chungyu710/Fusion/hardware/kicad/models/SP3T.step

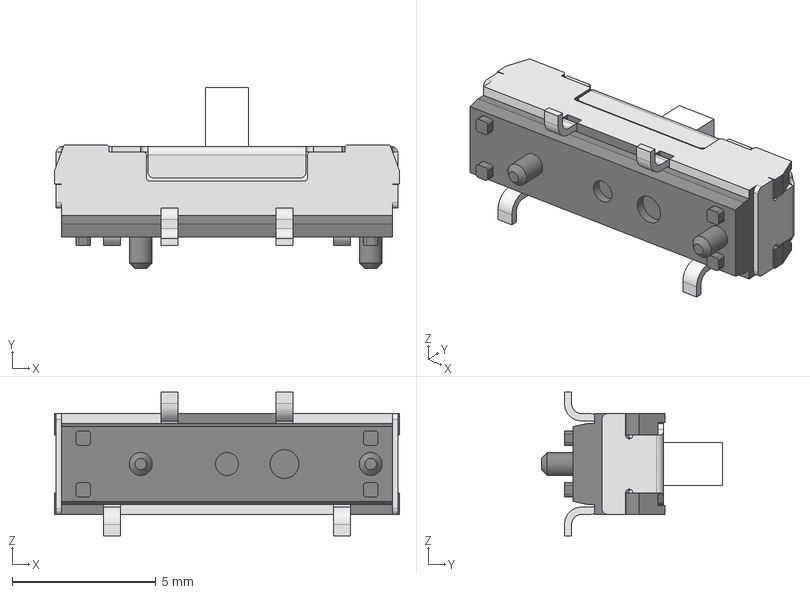
[picture p1: CAD file, 2022-07-06]
hardware/kicad/models/SP3T.step
12.0 x 6.30 x 5.00 mm
3Top setting_s
13B-01_c
