chungyu710/Fusion/hardware/kicad/models/SPDT.step

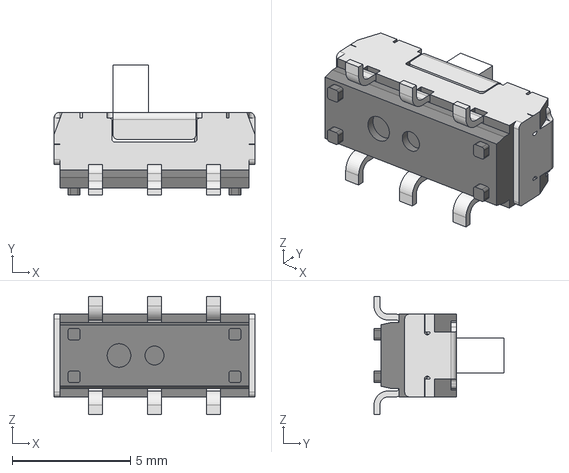
[picture p2: CAD file, 2022-07-06]
hardware/kicad/models/SPDT.step
8.50 x 5.50 x 5.00 mm
2Top setting_s
22B-01_c
