chungyu710/Fusion/hardware/kicad/models/JST.step

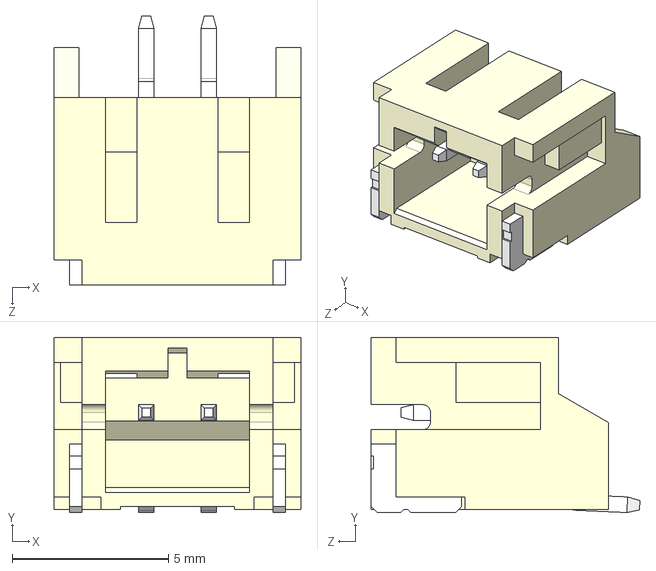
[picture p3: CAD file, 2022-07-06]
hardware/kicad/models/JST.step
7.90 x 5.60 x 8.60 mm
