chungyu710/Fusion/hardware/kicad/fusion.kicad_pcb

## KiCad design hardware/kicad/fusion.kicad_pcb (2022-07-08)

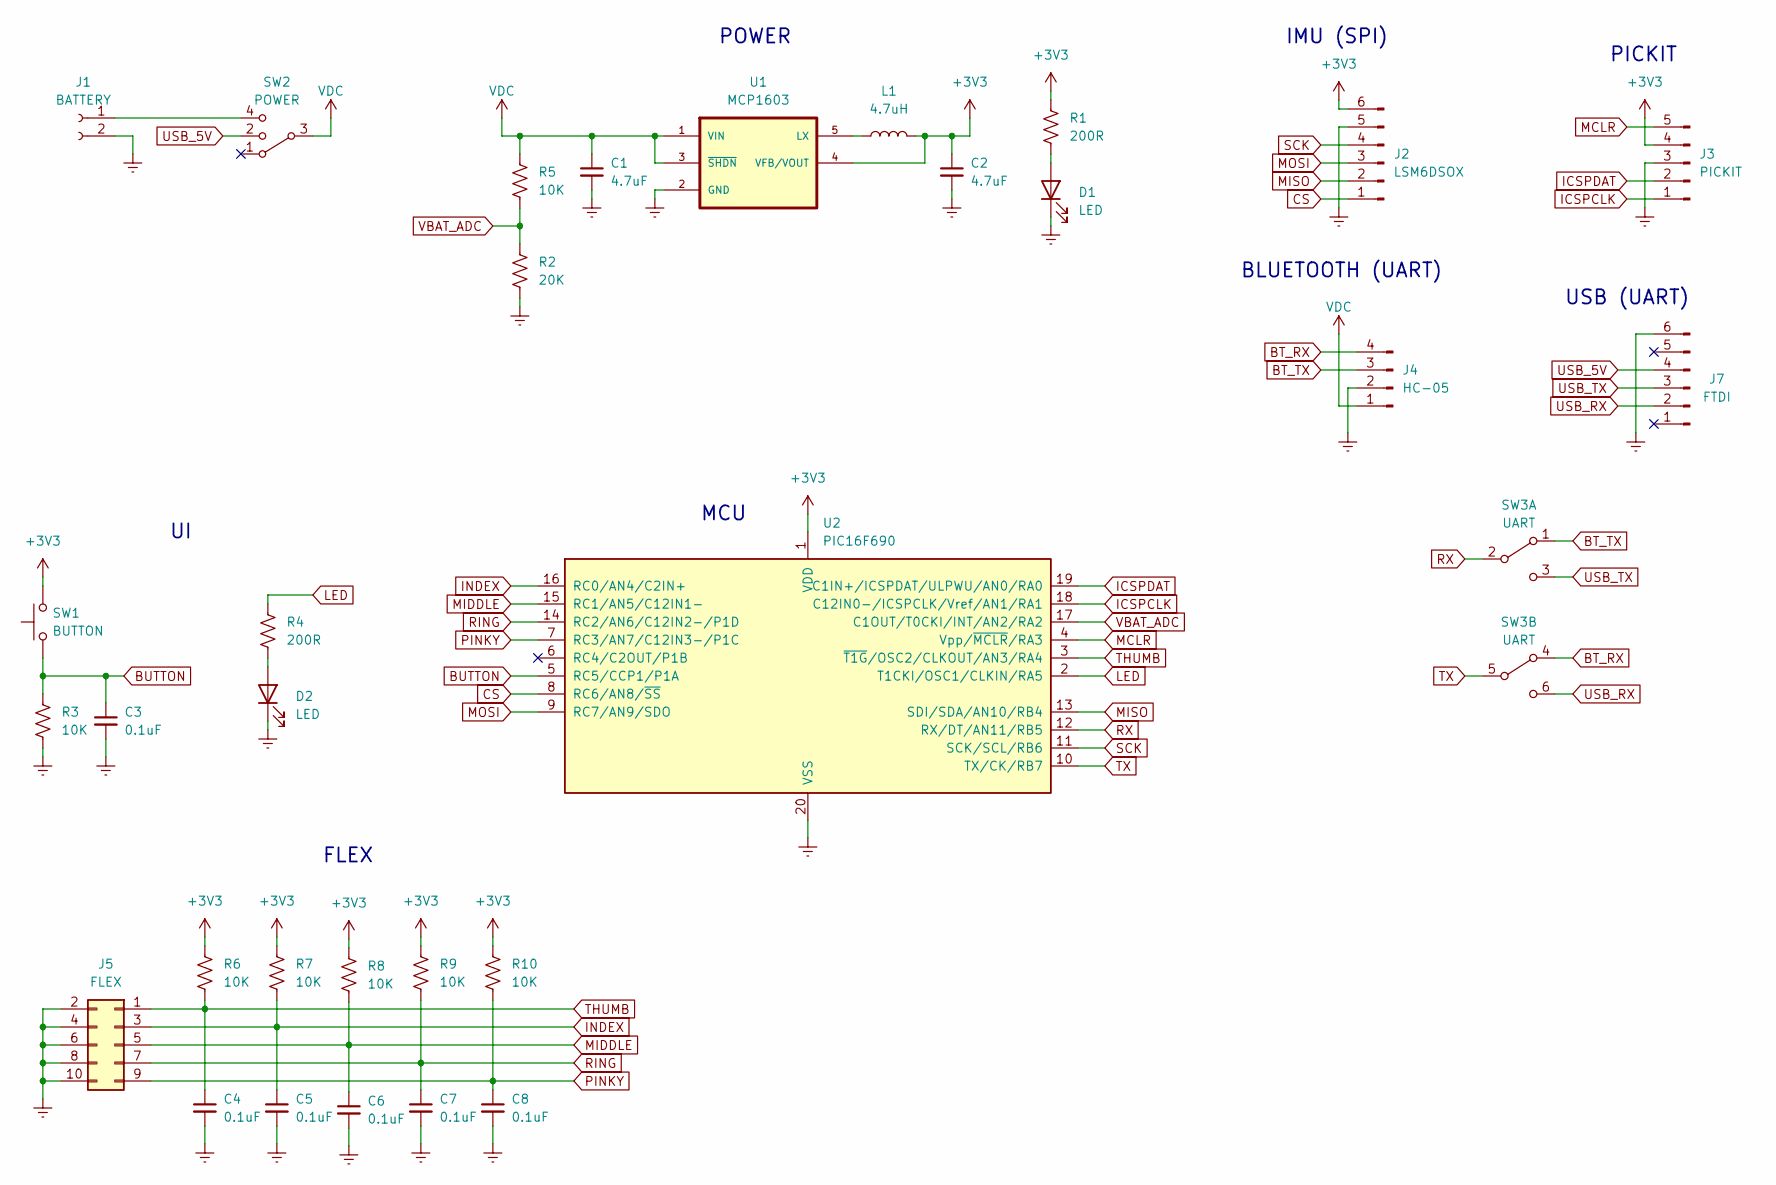
[picture p4: schematic fusion.kicad_sch]

Parts:
C1, C2: 4.7uF; C_0603_1608Metric_Pad1.08x0.95mm_HandSolder
C3, C4, C5, C6, C7, C8: 0.1uF; C_0603_1608Metric_Pad1.08x0.95mm_HandSolder
D1, D2: LED; LED_0603_1608Metric_Pad1.05x0.95mm_HandSolder
J1: BATTERY; JST
J2: LSM6DSOX; PinHeader_1x06_P2.54mm_Horizontal
J3: PICKIT; PinSocket_1x05_P2.54mm_Vertical
J4: HC-05; PinHeader_1x04_P2.54mm_Horizontal
J5: FLEX; PinHeader_2x05_P2.54mm_Horizontal
J7: FTDI; PinSocket_1x06_P2.54mm_Vertical
L1: 4.7uH; L_0603_1608Metric_Pad1.05x0.95mm_HandSolder
R1, R4: 200R; R_0603_1608Metric_Pad0.98x0.95mm_HandSolder
R2: 20K; R_0603_1608Metric_Pad0.98x0.95mm_HandSolder
R3, R5, R6, R7, R8, R9, R10: 10K; R_0603_1608Metric_Pad0.98x0.95mm_HandSolder
SW1: BUTTON; SW_PUSH_6mm_H5mm
SW2: POWER; SP3T
SW3: UART; SPDT
U1: MCP1603; TSOT-23-5_HandSoldering; MPN MCP1603T-330I/OS
U2: PIC16F690; DIP-20_W7.62mm_Socket

Connections:
+3V3: C2.1, J2.6, J3.4, L1.2, R1.2, R6.1, R7.1, R8.1, R9.1, R10.1, SW1.2, U1.4 (VFB/VOUT), U2.1 (VDD)
BT_RX: J4.4, SW3.4 (A)
BT_TX: J4.3, SW3.1 (A)
BUTTON: C3.1, R3.1, SW1.1, U2.5 (RC5/CCP1/P1A)
CS: J2.1, U2.8 (RC6/AN8/~SS)
GNDREF: C1.2, C2.2, C3.2, C4.2, C5.2, C6.2, C7.2, C8.2, D1.1 (K), D2.1 (K), J1.2, J2.5, J3.3, J4.2, J5.2, J5.4, J5.6, J5.8, J5.10, J7.6, R2.2, R3.2, U1.2 (GND), U2.20 (VSS)
ICSPCLK: J3.1, U2.18 (C12IN0-/ICSPCLK/Vref/AN1/RA1)
ICSPDAT: J3.2, U2.19 (C1IN+/ICSPDAT/ULPWU/AN0/RA0)
INDEX: C5.1, J5.3, R7.2, U2.16 (RC0/AN4/C2IN+)
LED: R4.2, U2.2 (T1CKI/OSC1/CLKIN/RA5)
MCLR: J3.5, U2.4 (Vpp/~MCLR/RA3)
MIDDLE: C6.1, J5.5, R8.2, U2.15 (RC1/AN5/C12IN1-)
MISO: J2.2, U2.13 (SDI/SDA/AN10/RB4)
MOSI: J2.3, U2.9 (RC7/AN9/SDO)
unnamed: D1.2 (A), R1.1
unnamed: D2.2 (A), R4.1
unnamed: J1.1, SW2.4
unnamed: L1.1, U1.5 (LX)
PINKY: C8.1, J5.9, R10.2, U2.7 (RC3/AN7/C12IN3-/P1C)
RING: C7.1, J5.7, R9.2, U2.14 (RC2/AN6/C12IN2-/P1D)
RX: SW3.2 (B), U2.12 (RX/DT/AN11/RB5)
SCK: J2.4, U2.11 (SCK/SCL/RB6)
THUMB: C4.1, J5.1, R6.2, U2.3 (~T1G/OSC2/CLKOUT/AN3/RA4)
TX: SW3.5 (B), U2.10 (TX/CK/RB7)
USB_5V: J7.4, SW2.2
USB_RX: J7.2, SW3.6 (C)
USB_TX: J7.3, SW3.3 (C)
VBAT_ADC: R2.1, R5.2, U2.17 (C1OUT/T0CKI/INT/AN2/RA2)
VDC: C1.1, J4.1, R5.1, SW2.3, U1.1 (VIN), U1.3 (~SHDN)

Notes on the sheet:
IMU (SPI)
MCU
FLEX
BLUETOOTH (UART)
PICKIT
USB (UART)
POWER

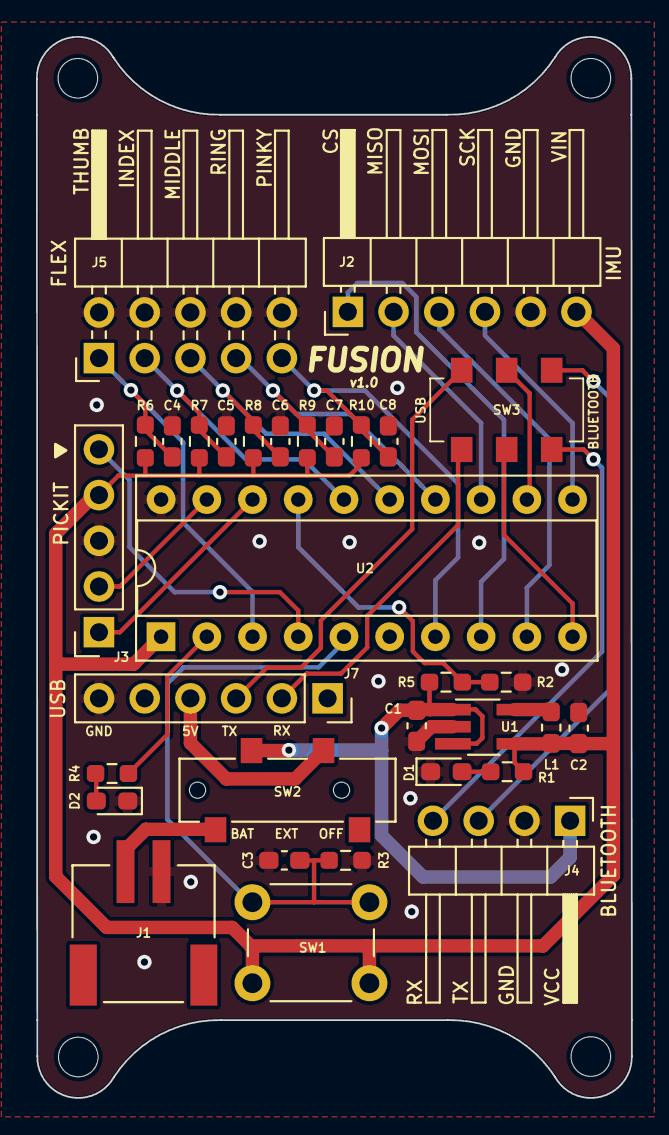
[picture p5: board fusion.kicad_pcb from above]

Board: 2 copper layers, 33.0 x 58.9 mm, 32 parts (0 on the bottom side), 29 nets.
