chungyu710/Fusion/(commit log)

2022-05-30 Hello world LED blink on 3V3
2022-06-02 System startup code with LED flash
2022-06-09 System initialization and LED (#1)
    - Reset all ports to digital outputs
    - Set oscillator frequency to 8 MHz (max speed)
    - Blink LED 3 times as a startup indicator
    - LED API
    [led.c, main.c, system.c, system.h]
2022-06-09 Fixed width integer types
    [types.h]
2022-06-09 Define APIs for drivers
2022-06-09 Revive the LED blink test
2022-06-09 Datasheets for MCU, buck, and IMU
2022-06-09 Power voltage return type (mV)
2022-06-09 Generate KiCad project files
    [fusion.kicad_pcb, fusion.kicad_sch]
2022-06-10 KiCad project settings
    [fusion.kicad_pcb, fusion.kicad_sch]
2022-06-10 Regenerate project
    [fusion.kicad_pcb, fusion.kicad_sch]
2022-06-10 Add MCP1603 buck symbol
2022-06-10 Make buck symbol less ugly
2022-06-10 Power system schematic
    [fusion.kicad_sch]
2022-06-10 IMU SPI header
    [fusion.kicad_sch]
2022-06-10 Rest of schematic
    [fusion.kicad_sch]
2022-06-12 Connect PIC pin to EN/KEY for BT instead of STATE
    [fusion.kicad_sch]
2022-06-14 Change battery monitor resistors to handle 5 V with less leakage
    [fusion.kicad_sch]
2022-06-14 Labels for switches
    [fusion.kicad_sch]
2022-06-14 Remove old version of buck symbol library
2022-06-15 Split IMU drivers into accel and gyro
2022-06-15 Empty source code files and fix syntax errors
    [accel.c, battery.c, button.c, flex.c, gyro.c, link.c, link.h, spi.c]
2022-06-15 Makefile printing
2022-06-17 chung's changes
    [fusion.kicad_sch]
2022-06-24 SPI working (read and write)
2022-06-24 SPI API for buffered reading and writing
2022-06-24 IMU drivers for reading and writing registers
2022-06-24 Multi-byte read/write for IMU over SPI
2022-06-24 Wrappers for reading and writing single IMU register
2022-06-24 Read accel X with multi byte SPI read command
2022-06-24 Read all accel axes with one SPI command
2022-06-24 Read gyro and reorder struct for continuous read
2022-06-24 Dynamic gyro range
2022-06-27 Select some footprints
    [fusion.kicad_sch]
2022-06-27 0603 footprints and SP3T
    [fusion.kicad_pcb, fusion.kicad_sch]
2022-06-29 Placing components
    [fusion.kicad_pcb, fusion.kicad_sch]
2022-06-30 Moving around components
    [fusion.kicad_pcb]
2022-07-03 Models and footprints for JST and switches
    [JST.step, SP3T.step, SPDT.step]
2022-07-03 Route board
    [fusion.kicad_pcb, fusion.kicad_sch]
2022-07-04 Rounded corners, mounting holes, and DRC
    [fusion.kicad_pcb, fusion.kicad_sch]
2022-07-05 PCB cleanup and branding
    [fusion.kicad_pcb]
2022-07-05 Enable brownout reset to stabilize power-on reset
    PC was not being reset on power up.
    [system.c]
2022-07-06 add code for calibration processor
2022-07-06 added uart tx/rx functionality
2022-07-06 Switch to final UART drivers
2022-07-07 Power HC-05 from raw power source
    BT module has an LDO that requires at least 3V6.
    Powering from 3V3 causes improper regulation and
    browns out the entire system.
    [fusion.kicad_pcb, fusion.kicad_sch]
2022-07-07 Better ground stitching and silk fix for power switch
    [fusion.kicad_pcb]
2022-07-07 Change LED resistors to 200R (DigiKey availability)
    [fusion.kicad_pcb, fusion.kicad_sch]
2022-07-07 LED blink forever
    Useful for errors
    [led.c, main.c]
2022-07-08 Implement Chung's feedback for PCB
    [fusion.kicad_pcb, fusion.kicad_sch]
2022-07-08 small routing changes
    [fusion.kicad_pcb]
2022-07-12 Some constants for ADC
2022-07-12 Switch LED resistors to 220R as per DigiKey availability
    [fusion.kicad_sch]
2022-07-23 velocity testing and mouse with gyro
2022-07-23 Control mouse with gyro
2022-07-23 Basic sensor reading (no flex)
    [link.h, main.c, system.c, system.h]
2022-07-23 Service firmware (reset not implemented)
    [battery.c, flex.c, link.c, main.c, system.c, system.h]
2022-07-23 Change LED pin to match PCB
2022-07-23 Sample testing script
2022-07-23 Measure latency and switch mouse axes
2022-07-23 Abort with blinking LED forever
    - also included dummy flex data
    [accel.c, flex.c, gyro.c, imu.c, spi.c, system.c, system.h]
2022-07-23 Reset using watchdog and run service in interrupt
    [main.c, sample.py, system.c, uart.c]
2022-07-23 Button firmware
2022-07-23 Dummy battery firmware
2022-07-23 cleanup and finish initializing drivers
2022-07-23 Send button with sensors
2022-07-23 Parse button in deserializer
2022-07-23 Battery command testing
2022-07-23 Check if IMU is online
2022-07-23 Press button to reboot during an abort
    [fusion.py, system.c, system.h]
2022-07-23 Change battery undervolt threshold to 3V6 for HC-05 LDO
2022-07-23 Stack print sensors
2023-01-22 add code for flex sensors
    [agent.py, fusion.py, state_lookup.py]
2023-01-24 added flex sensor adc code
    [adc.c, adc.h, flex.c, system.h]
2023-01-27 Read battery voltage and detect undervolting
2023-01-27 Fix IMU whoami check
    [imu.c]
2023-01-27 Reboot after pressing button during abort
    [system.c]
2023-01-27 Power sequencing delay for IMU initialization
2023-01-27 Check for low battery on boot
2023-01-27 Abort reason and fix GIE race condition
    [accel.c, battery.c, gyro.c, imu.c, main.c, spi.c, system.c, system.h]
2023-01-27 Remove battery check on startup (not reliable)
2023-01-27 Periodic battery voltage check
2023-01-27 Debounce low battery voltage on boot
2023-02-14 added calibration script; good enough for initial demo?
2023-02-19 ping and reset on startup
    [deserializer.py]
2023-02-19 Fix sample
2023-02-19 verify checksum on ping and reset
    [deserializer.py]
2023-02-19 remove printf
2023-02-19 Rename sensors command to sample
2023-02-19 copy sample.py
2023-02-20 single threaded consistent
2023-02-20 Reduce wireless latency using burst mode
2023-02-20 clean up sample and burst
2023-02-20 Move battery check code
2023-02-20 Change undervolt to 3.3 V
2023-02-20 battery voltage test script
2023-02-21 Reprint battery voltage
2023-02-21 Calibration left hand ring finger
2023-02-22 Fix out of scope variable
    [link.c]
2023-02-22 Send battery low voltage when entering UVLO
2023-02-22 Revert undervolt back to 3.4 V
    [battery.c]
2023-02-23 latency print
2023-03-03 updated calibrate file
2023-03-03 fixed single click mode
    [fusion.py]
2023-03-03 Revert "Easter egg"
    This reverts commit deea70c4c1628a4b67211d04470c2c8752b901dd.
    [fusion.py]
2023-03-04 Put back --port args in battery.py
2023-03-12 fix battery print
2023-03-12 fix burst race condition
    [main.c]
2023-03-14 Fixed ring sensor
