chungyu710/Fusion/(notices)

Notices in the files:
hardware/kicad/models/SP3T.step:
author */ ('License CC BY-ND 4.0'),
